bvarner/pidroponics/pidroponic_uHAT/pidroponic_uHAT.png

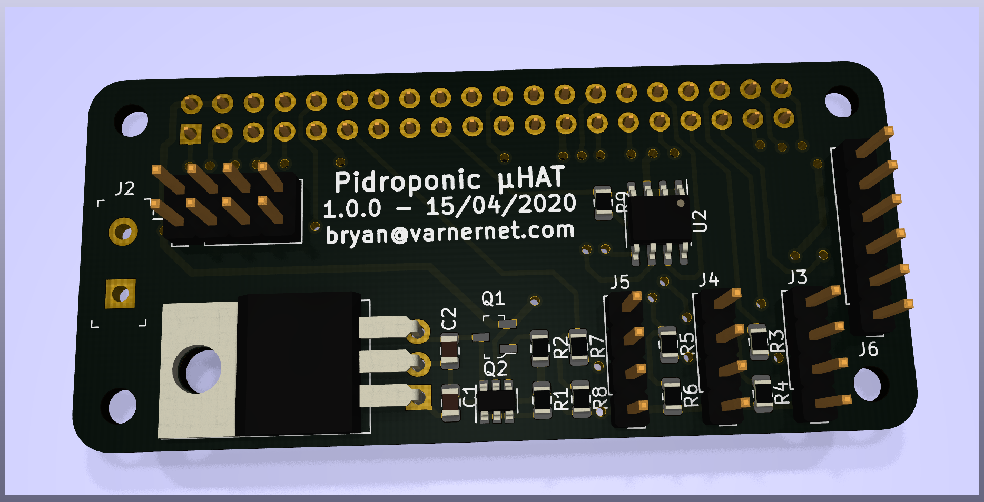
pidroponic_uHAT/pidroponic_uHAT.png
