bvarner/pidroponics/pidroponic_uHAT/pidroponic_uHAT.jpg

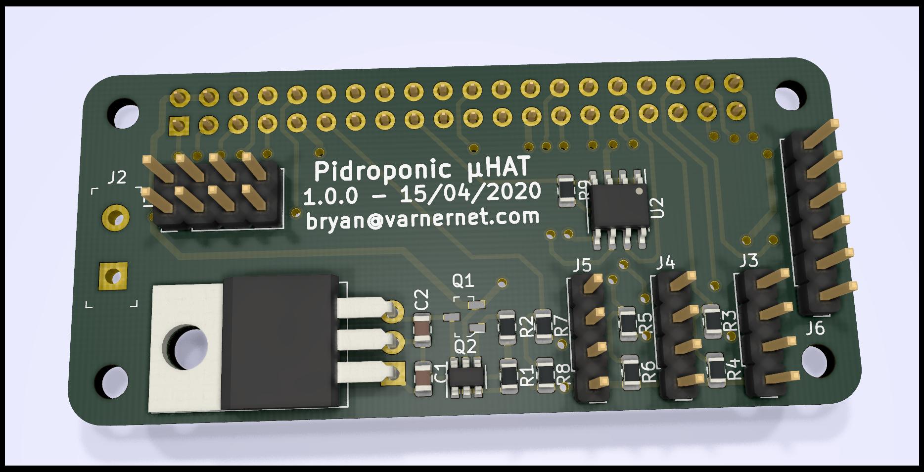
pidroponic_uHAT/pidroponic_uHAT.jpg
