bvarner/pidroponics/README.md

# pidroponics
RaspberryPi Controlled Hydroponics!
