bvarner/pidroponics/pidroponic_uHAT/pidroponic_uHAT.kicad_pcb

## KiCad design pidroponic_uHAT/pidroponic_uHAT.kicad_pcb (2020-05-28)

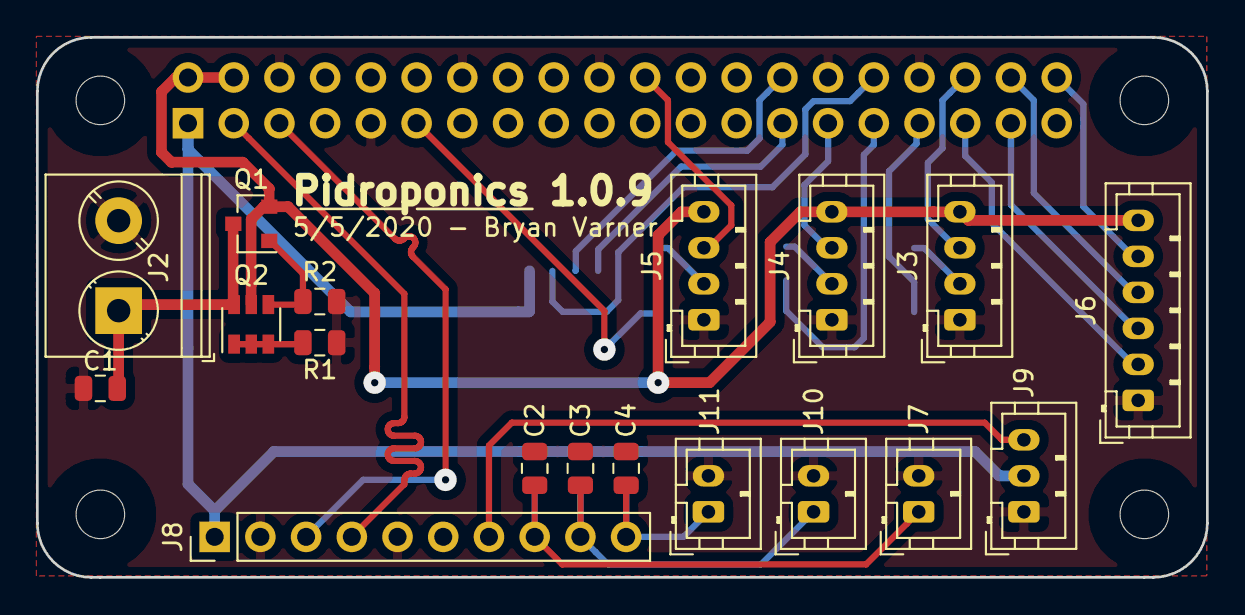
[picture p3: board pidroponic_uHAT.kicad_pcb from above]

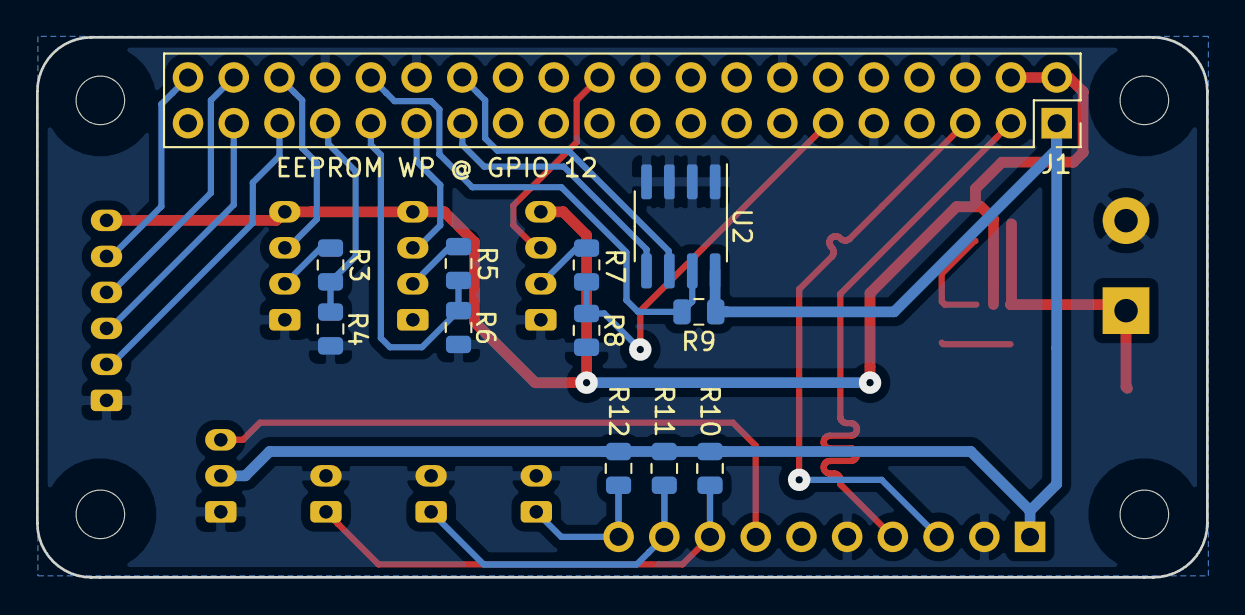
[picture p4: board pidroponic_uHAT.kicad_pcb from below]

Board: 2 copper layers, 65.0 x 30.0 mm, 34 parts (12 on the bottom side), 28 nets.

Parts:
C1, C2, C3, C4: 10uf; C_0805_2012Metric
H1, H2, H3, H4: MountingHole; MountingHole_2.7mm_M2.5_uHAT_RPi
J1: GPIO_CONNECTOR; PinSocket_2x20_P2.54mm_Vertical_Centered_Anchor
J2: 1935161; TerminalBlock_Phoenix_PT-1,5-2-5.0-H_1x02_P5.00mm_Horizontal
J3: Prox 0; JST_PH_B4B-PH-K_1x04_P2.00mm_Vertical
J4: Prox 1; JST_PH_B4B-PH-K_1x04_P2.00mm_Vertical
J5: Prox 2; JST_PH_B4B-PH-K_1x04_P2.00mm_Vertical
J6: 4 Chan Relay; JST_PH_B6B-PH-K_1x06_P2.00mm_Vertical
J7: Therm 0; JST_PH_B2B-PH-K_1x02_P2.00mm_Vertical
J8: TI ADS1115 Breakout Board; PinHeader_1x10_P2.54mm_Vertical
J9: Analog PH; JST_PH_B3B-PH-K_1x03_P2.00mm_Vertical
J10: Therm 1; JST_PH_B2B-PH-K_1x02_P2.00mm_Vertical
J11: Therm 2; JST_PH_B2B-PH-K_1x02_P2.00mm_Vertical
Q1: DMG2305UX-13; SOT-23
Q2: DMMT5401; SOT-23-6
R1, R9: 10K; R_0805_2012Metric
R2: 47K; R_0805_2012Metric
R3, R5, R7: 3k; R_0805_2012Metric
R4, R6, R8: 3.9k; R_0805_2012Metric
R10, R11, R12: 4.7k; R_0805_2012Metric
U2: CAT24C32; SOIC-8_3.9x4.9mm_P1.27mm

Connections:
+3V3: J1.1, J8.1, J9.2, R9.1, R10.1, R11.1, R12.1, U2.8
+5V: J1.2, J1.4, J3.4, J4.4, J5.4, J6.6, Q1.2, Q2.5
/A0: J8.7, J9.3
/A1: C2.1, J7.1, J8.8, R10.2
/A2: C3.1, J8.9, J10.1, R11.2
/A3: C4.1, J8.10, J11.1, R12.2
/ECHO_0: J3.2, R3.1
/ECHO_1: J4.2, R5.1
/ECHO_2: J5.2, R7.1
/EXT5V: C1.1, J2.1, Q1.3, Q2.6
/GPIO2_SDA1: J1.3, J8.4
/GPIO3_SCL1: J1.5, J8.3
/GPIO5: J1.29, J4.3
/GPIO6: J1.31, R5.2, R6.1
/GPIO12: J1.32, R9.2, U2.7
/GPIO13: J1.33, R3.2, R4.1
/GPIO16: J1.36, J3.3
/GPIO17: J1.11, R7.2, R8.1
/GPIO19: J1.35, J6.2
/GPIO20: J1.38, J6.4
/GPIO21: J1.40, J6.5
/GPIO25: J1.22, J5.3
/GPIO26: J1.37, J6.3
/ID_SC: J1.28, U2.6
/ID_SD: J1.27, U2.5
GND: C1.2, C2.2, C3.2, C4.2, J1.6, J1.9, J1.14, J1.20, J1.30, J1.34, J2.2, J3.1, J4.1, J5.1, J6.1, J7.2, J8.2, J8.5, J9.1, J10.2, J11.2, R1.2, R2.2, R4.2, R6.2, R8.2, U2.1, U2.2, U2.3, U2.4
unnamed: Q1.1, Q2.4, R2.1
unnamed: Q2.1, Q2.2, Q2.3, R1.1
