bvarner/pidroponics/(commit log)

2020-04-14 Removing the second sensor from the code to debug...
2020-04-14 Gutting this thing. If I can't get accurate measurements with periph.io, I'll have to drop back to driver dev land.
2020-04-24 Adding the uHAT hardware.
    [pidroponic_uHAT.kicad_pcb, pidroponic_uHAT.sch, pidroponic_uHAT_bom.csv, pidroponic_uHAT_homeproto.kicad_pcb]
2020-04-24 * Read device paths a bit better and take more appropriate actions.
2020-04-24 echo the devicename buffer.
2020-04-25 Trying to get the device name to read properly.
2020-04-25 ioutils.readfile is returning the line-feed at the end of the device name contents.
2020-04-25 I forgot it was relay state being emitted.
2020-04-26 The device returns a timeout from 'cat' but the goland read tools just hit EOF.
2020-04-27 Try opening it like a socket?
2020-04-27 Let's try it as a char device.
2020-04-29 updates over the last few evenings.
    [pidroponic_uHAT.kicad_pcb, pidroponic_uHAT.sch]
2020-04-29 tighten up
2020-05-05 Update to the uHAT, given learning new things.
    * Removed the 5v linear regulator. Relays draw too much current for this to be safe. Off-board switching DC-DC buck converters are inexpensive up to 3A. Recommend using an LM2596 board.
    * ADC pins configured for 3 thermistors (4.7k pullup through thermistor + filter cap) + one direct ADC feed for connecting a 3.3v analog PH Sensor
    * Unified board design specs to make the 'fab' one the same as the 'homeproto'. We'll try traces this big with home proto and see where that gets us. In that vein, removed all but four vias.
    General notes about this version:
    * Soldering both sides of the header pins makes it possible to use those pads as vias, greatly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
    [pidroponic_uHAT.kicad_pcb, pidroponic_uHAT.sch, pidroponic_uHAT_homeproto.kicad_pcb]
2020-05-08 * Refactoring device detection. * Cleaning up init. * MOving toward getting the NTC and the PH Detector setup.
    [pidroponic_uHAT.kicad_pcb]
2020-05-11 Adding initial support for ntc-thermistors...
2020-05-11 yeah, these put out temperatures.
2020-05-11 * decoupled broadcast from poll. * Ph probe userspace support. * mutexes protecting rings.
2020-05-11 Emit each device each second.
2020-05-28 Pidroponics 1.0.9 PCB & Gerbers.
    [pidroponic_uHAT-B_Cu.gbl, pidroponic_uHAT-B_Mask.gbs, pidroponic_uHAT-B_Paste.gbp, pidroponic_uHAT-B_SilkS.gbo, pidroponic_uHAT-Edge_Cuts.gm1, pidroponic_uHAT-F_Cu.gtl, pidroponic_uHAT-F_Mask.gts, pidroponic_uHAT-F_Paste.gtp]
