bvarner/pidroponics/(notices)

Notices in the files:
pidroponic_uHAT/pidroponic_uHAT.sch:
This Schematic is licensed under Apache License Version 2.0
pidroponic_uHAT/pidroponic_uHAT.kicad_pcb:
This PCB design is licensed under MIT Open Source License.
